eric-wood/presets-pedal-template/template.kicad_pcb

## KiCad design template.kicad_pcb (2021-06-12)

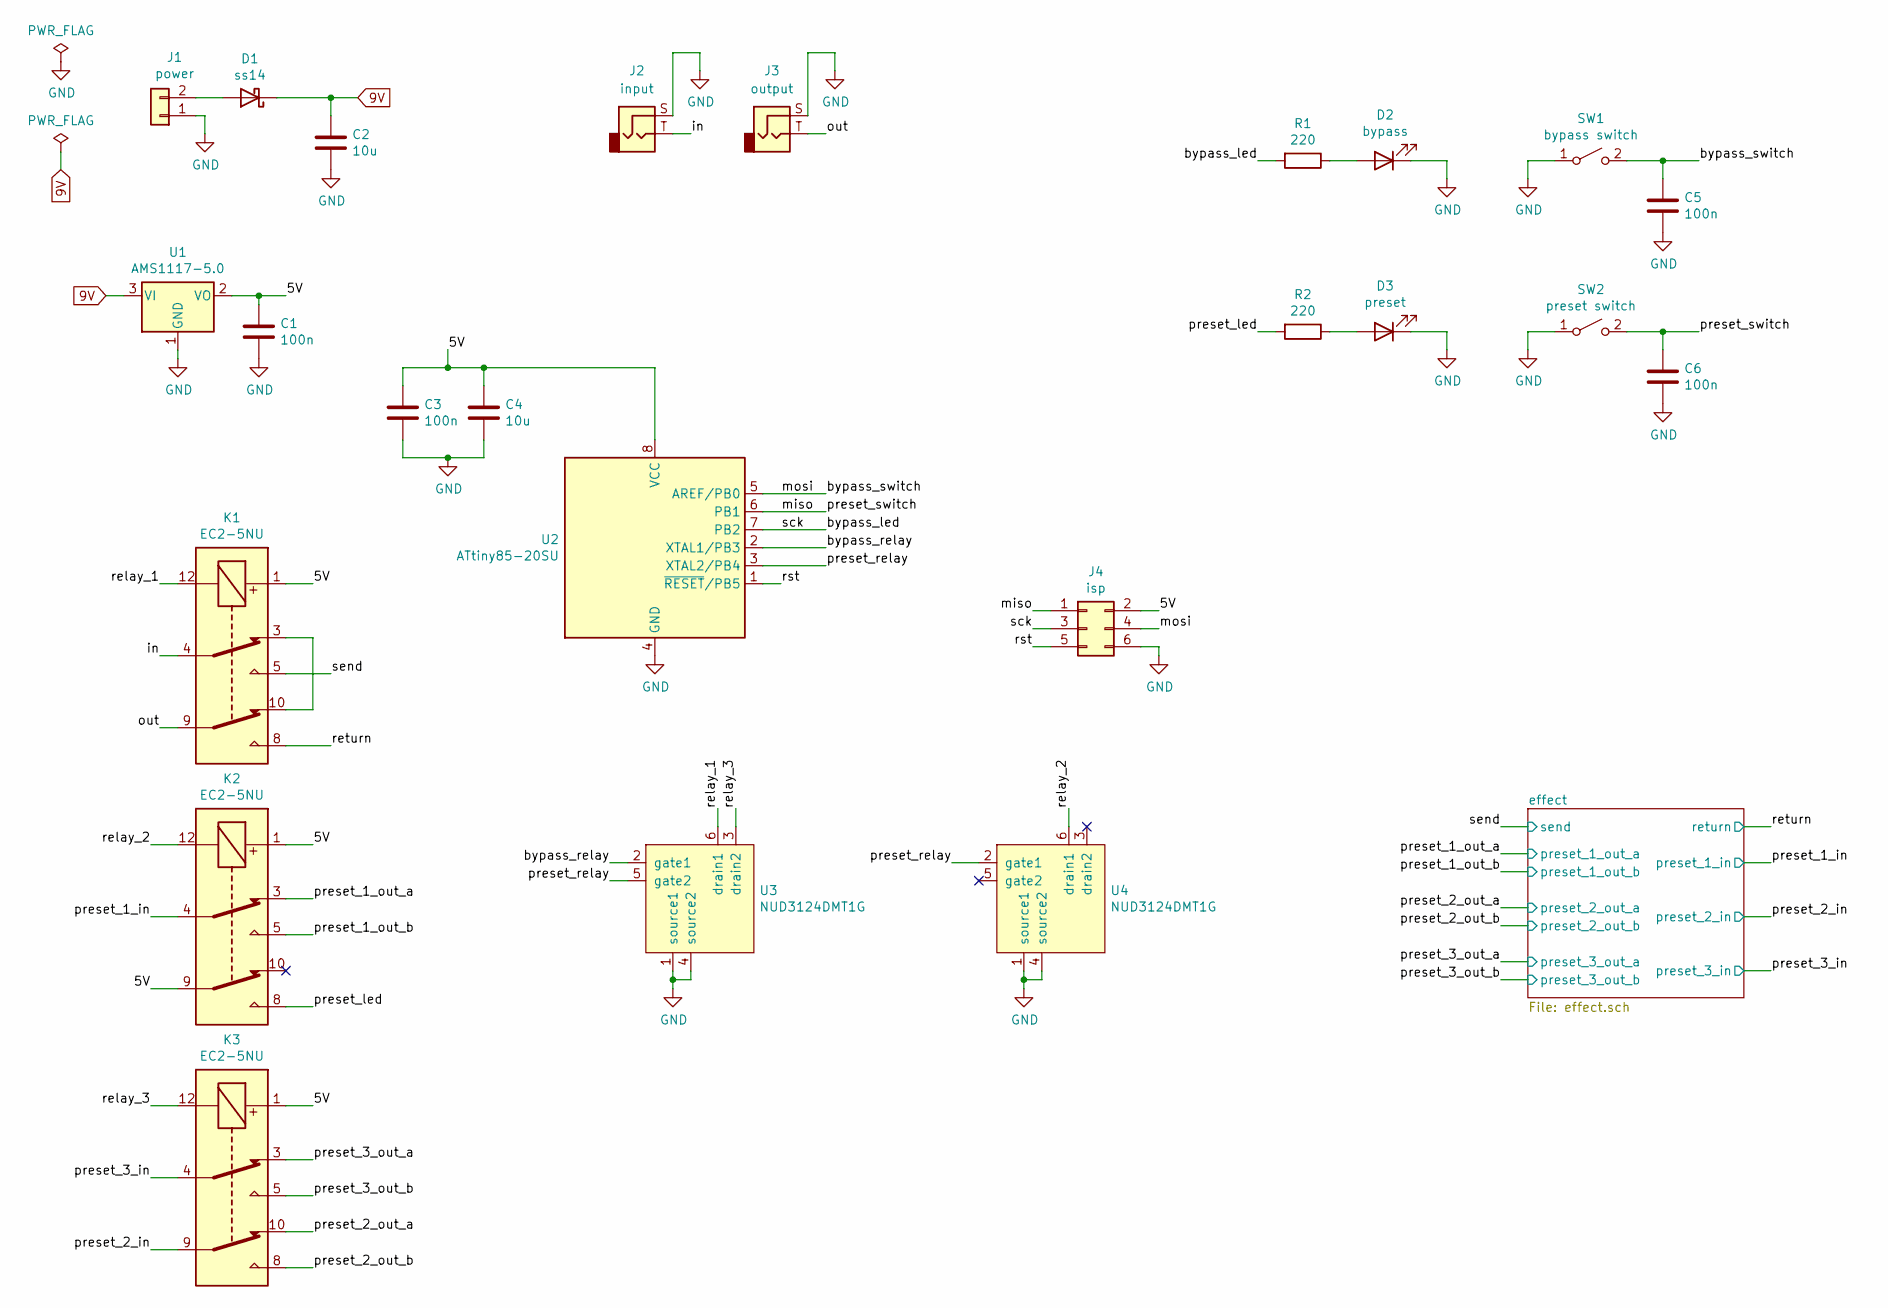
[picture p1: schematic template.sch]

Parts:
C1, C3, C5, C6: 100n; C_0603_1608Metric; LCSC C14663
C2, C4: 10u; C_1206_3216Metric; LCSC C13585
D1: ss14; D_SMA; LCSC C2480
D2: bypass; LED_D5.0mm_compact
D3: preset; LED_D5.0mm_compact
J1: power; PinHeader_1x02_P2.54mm_Vertical
J2: input; Jack_6.35mm_Neutrik_NMJ4HCD2_Horizontal
J3: output; Jack_6.35mm_Neutrik_NMJ4HCD2_Horizontal
J4: isp; PinHeader_2x03_P2.54mm_Vertical
K1, K2, K3: EC2-5NU; Relay_DPDT_Kemet_EC2
R1, R2: 220; R_0603_1608Metric; LCSC C22962
SW1: bypass switch; JST_XH_B2B-XH-A_1x02_P2.50mm_Vertical
SW2: preset switch; JST_XH_B2B-XH-A_1x02_P2.50mm_Vertical
U1: AMS1117-5.0; SOT-223-3_TabPin2; LCSC C6187
U2: ATtiny85-20SU; SOIJ-8_5.3x5.3mm_P1.27mm
U3, U4: NUD3124DMT1G; SC-74-6_1.5x2.9mm_P0.95mm

Connections:
9V: C2.1, D1.1 (K), U1.3 (VI); also elsewhere on the board
/5V: C1.1, C3.1, C4.1, J4.2, K1.1, K2.1, K2.9, K3.1, U1.2 (VO), U2.8 (VCC)
/bypass_led: J4.3, R1.2, U2.7 (PB2)
/bypass_relay: U2.2 (XTAL1/PB3), U3.2 (gate1)
/bypass_switch: C5.1, J4.4, SW1.2 (B), U2.5 (AREF/PB0)
/in: J2.T, K1.4
/miso: C6.1, J4.1, SW2.2 (B), U2.6 (PB1)
/out: J3.T, K1.9
/preset_1_in: K2.4; also elsewhere on the board
/preset_1_out_a: K2.3; also elsewhere on the board
/preset_1_out_b: K2.5; also elsewhere on the board
/preset_2_in: K3.9; also elsewhere on the board
/preset_2_out_a: K3.10; also elsewhere on the board
/preset_2_out_b: K3.8; also elsewhere on the board
/preset_3_in: K3.4; also elsewhere on the board
/preset_3_out_a: K3.3; also elsewhere on the board
/preset_3_out_b: K3.5; also elsewhere on the board
/preset_led: K2.8, R2.2
/preset_relay: U2.3 (XTAL2/PB4), U3.5 (gate2), U4.2 (gate1)
/relay_1: K1.12, U3.6 (drain1)
/relay_2: K2.12, U4.6 (drain1)
/relay_3: K3.12, U3.3 (drain2)
/return: K1.8; also elsewhere on the board
/rst: J4.5, U2.1 (~RESET~/PB5)
/send: K1.5; also elsewhere on the board
GND: C1.2, C2.2, C3.2, C4.2, C5.2, C6.2, D2.1 (K), D3.1 (K), J1.1, J2.S, J3.S, J4.6, SW1.1 (A), SW2.1 (A), U1.1 (GND), U2.4 (GND), U3.1 (source1), U3.4 (source2), U4.1 (source1), U4.4 (source2); also elsewhere on the board
unnamed: D1.2 (A), J1.2
unnamed: D2.2 (A), R1.1
unnamed: D3.2 (A), R2.1
unnamed: K1.3, K1.10

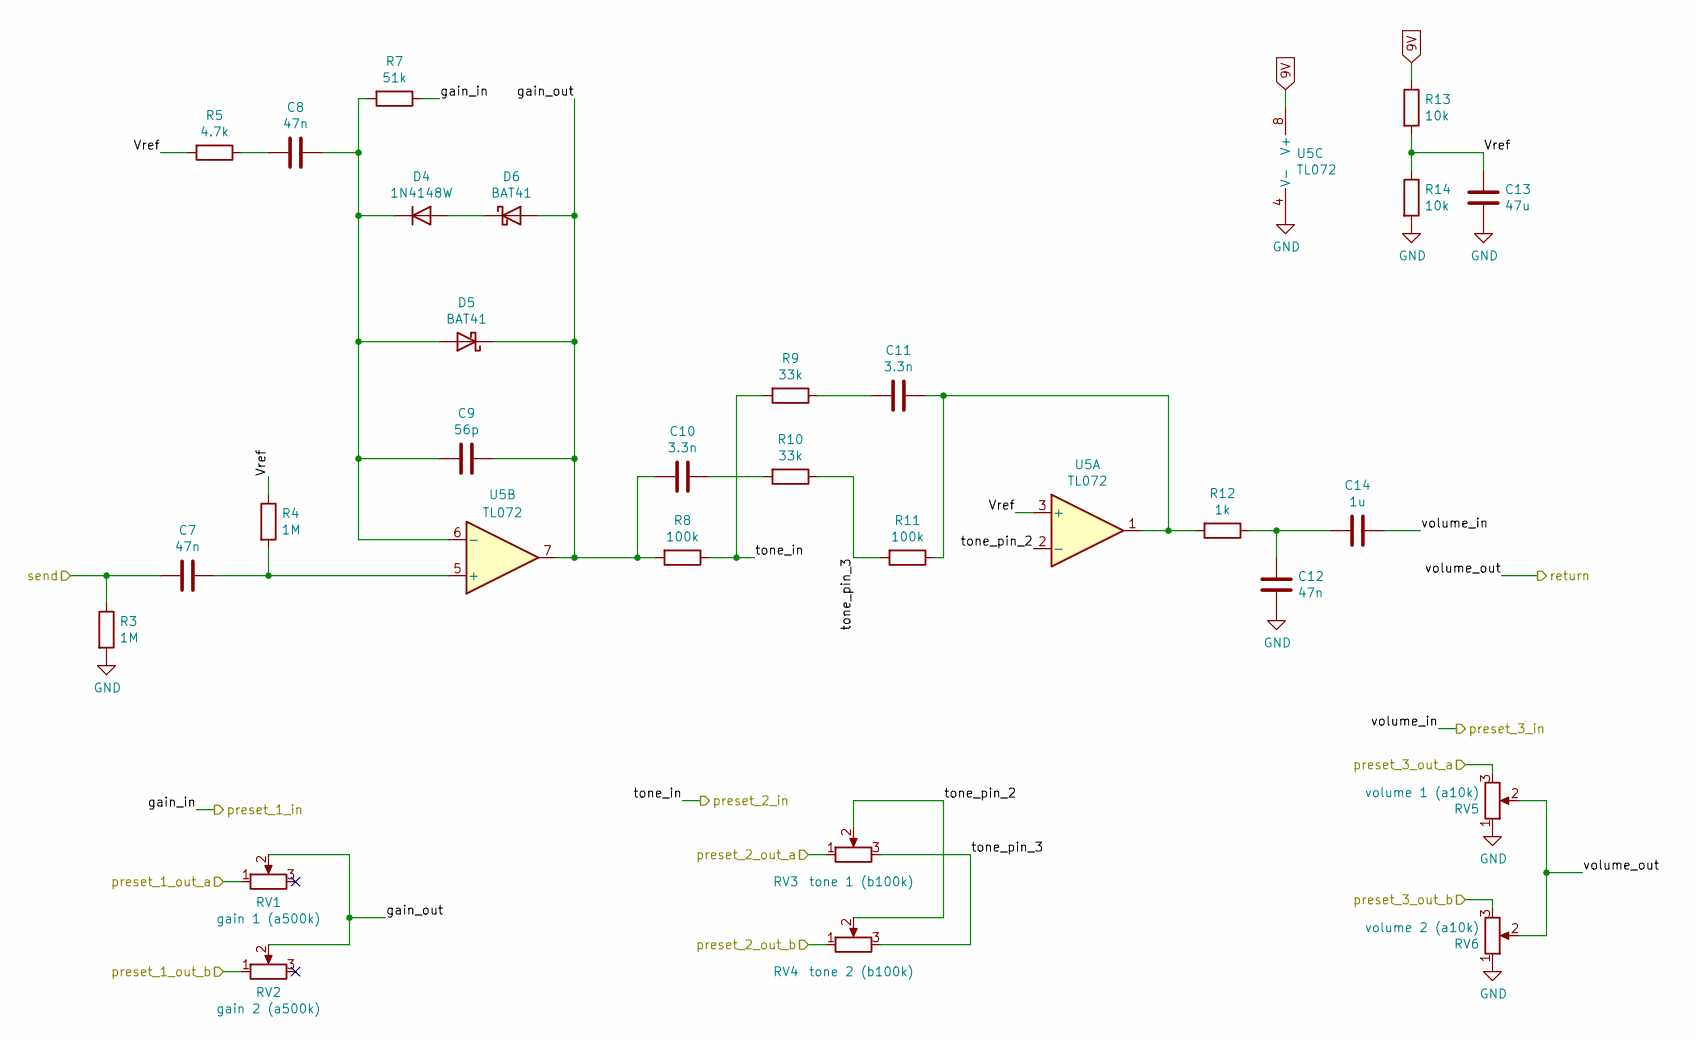
[picture p2: schematic effect.sch]

Parts:
C7, C8, C12: 47n; C_0603_1608Metric; LCSC C1622
C9: 56p; C_0603_1608Metric; LCSC C39148
C10, C11: 3.3n; C_0603_1608Metric; LCSC C1613
C13: 47u; C_1206_3216Metric; LCSC C96123
C14: 1u; C_0603_1608Metric; LCSC C15849
D4: 1N4148W; D_SOD-123; LCSC C81598
D5, D6: BAT41; D_DO-35_SOD27_P7.62mm_Horizontal
R3, R4: 1M; R_0603_1608Metric; LCSC C22935
R5: 4.7k; R_0603_1608Metric; LCSC C23162
R7: 51k; R_0603_1608Metric; LCSC C23196
R8, R11: 100k; R_0603_1608Metric; LCSC C25803
R9, R10: 33k; R_0603_1608Metric; LCSC C4216
R12: 1k; R_0603_1608Metric; LCSC C21190
R13, R14: 10k; R_0603_1608Metric; LCSC C25804
RV1: gain 1 (a500k); alpha_pot_16mm
RV2: gain 2 (a500k); alpha_pot_16mm
RV3: tone 1 (b100k); alpha_pot_16mm
RV4: tone 2 (b100k); alpha_pot_16mm
RV5: volume 1 (a10k); alpha_pot_16mm
RV6: volume 2 (a10k); alpha_pot_16mm
U5: TL072; SOIC-8_3.9x4.9mm_P1.27mm; LCSC C6961

Connections:
9V: R13.1, U5.8 (V+); also elsewhere on the board
/effect/Vref: C13.1, R4.1, R5.2, R13.2, R14.1, U5.3 (+)
/effect/gain_out: C9.1, C10.2, D5.1 (K), D6.2 (A), R8.2, RV1.2, RV2.2, U5.7
/effect/tone_pin_2: RV3.2, RV4.2, U5.2 (-)
/effect/tone_pin_3: R10.1, R11.2, RV3.3, RV4.3
/preset_1_in: R7.1; also elsewhere on the board
/preset_1_out_a: RV1.1; also elsewhere on the board
/preset_1_out_b: RV2.1; also elsewhere on the board
/preset_2_in: R8.1, R9.2; also elsewhere on the board
/preset_2_out_a: RV3.1; also elsewhere on the board
/preset_2_out_b: RV4.1; also elsewhere on the board
/preset_3_in: C14.1; also elsewhere on the board
/preset_3_out_a: RV5.3; also elsewhere on the board
/preset_3_out_b: RV6.3; also elsewhere on the board
/return: RV5.2, RV6.2; also elsewhere on the board
/send: C7.2, R3.1; also elsewhere on the board
GND: C12.1, C13.2, R3.2, R14.2, RV5.1, RV6.1, U5.4 (V-); also elsewhere on the board
unnamed: C7.1, R4.2, U5.5 (+)
unnamed: C8.1, C9.2, D4.1 (K), D5.2 (A), R7.2, U5.6 (-)
unnamed: C8.2, R5.1
unnamed: C10.1, R10.2
unnamed: C11.1, R11.1, R12.2, U5.1
unnamed: C11.2, R9.1
unnamed: C12.2, C14.2, R12.1
unnamed: D4.2 (A), D6.1 (K)

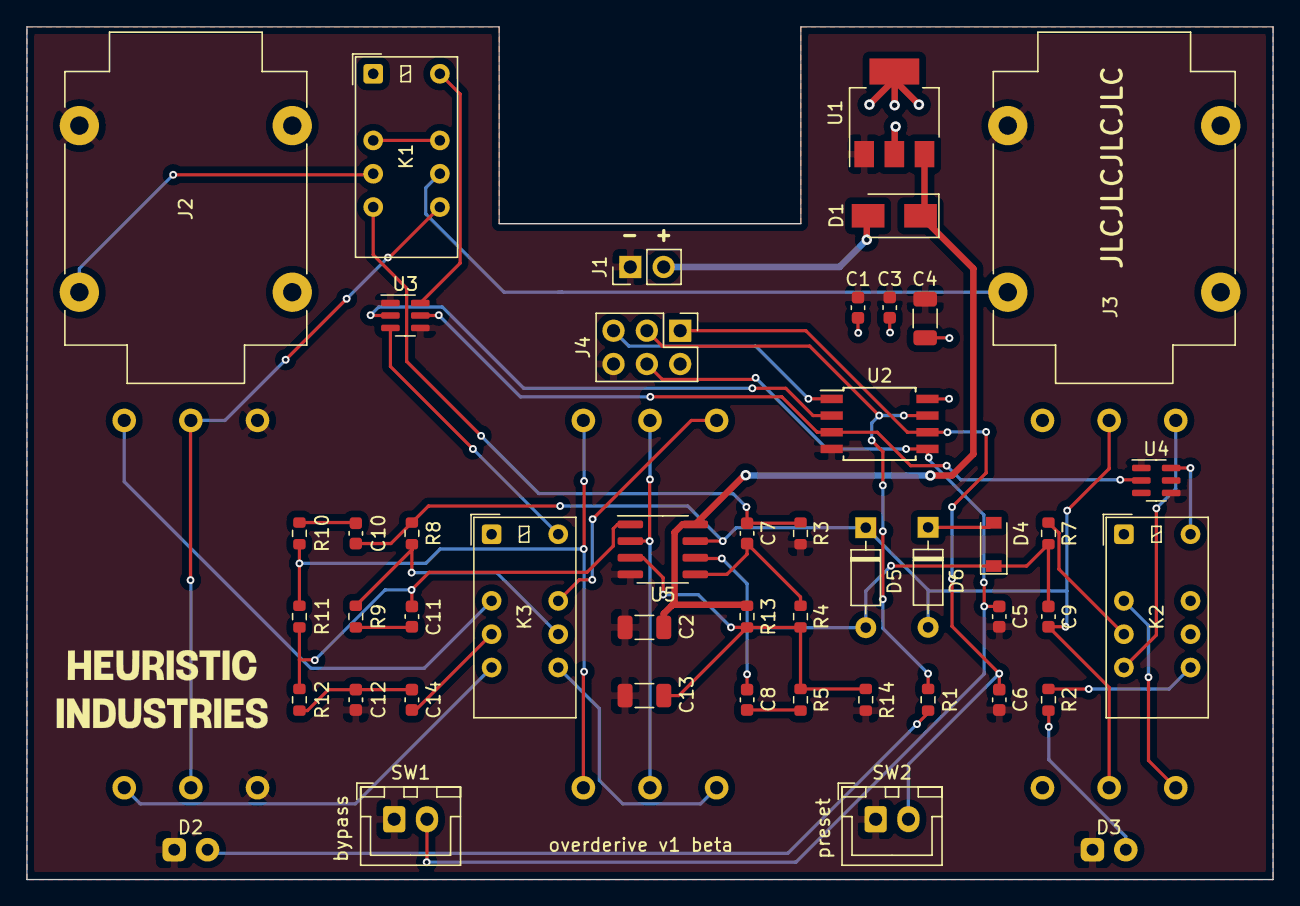
[picture p3: board template.kicad_pcb from above]

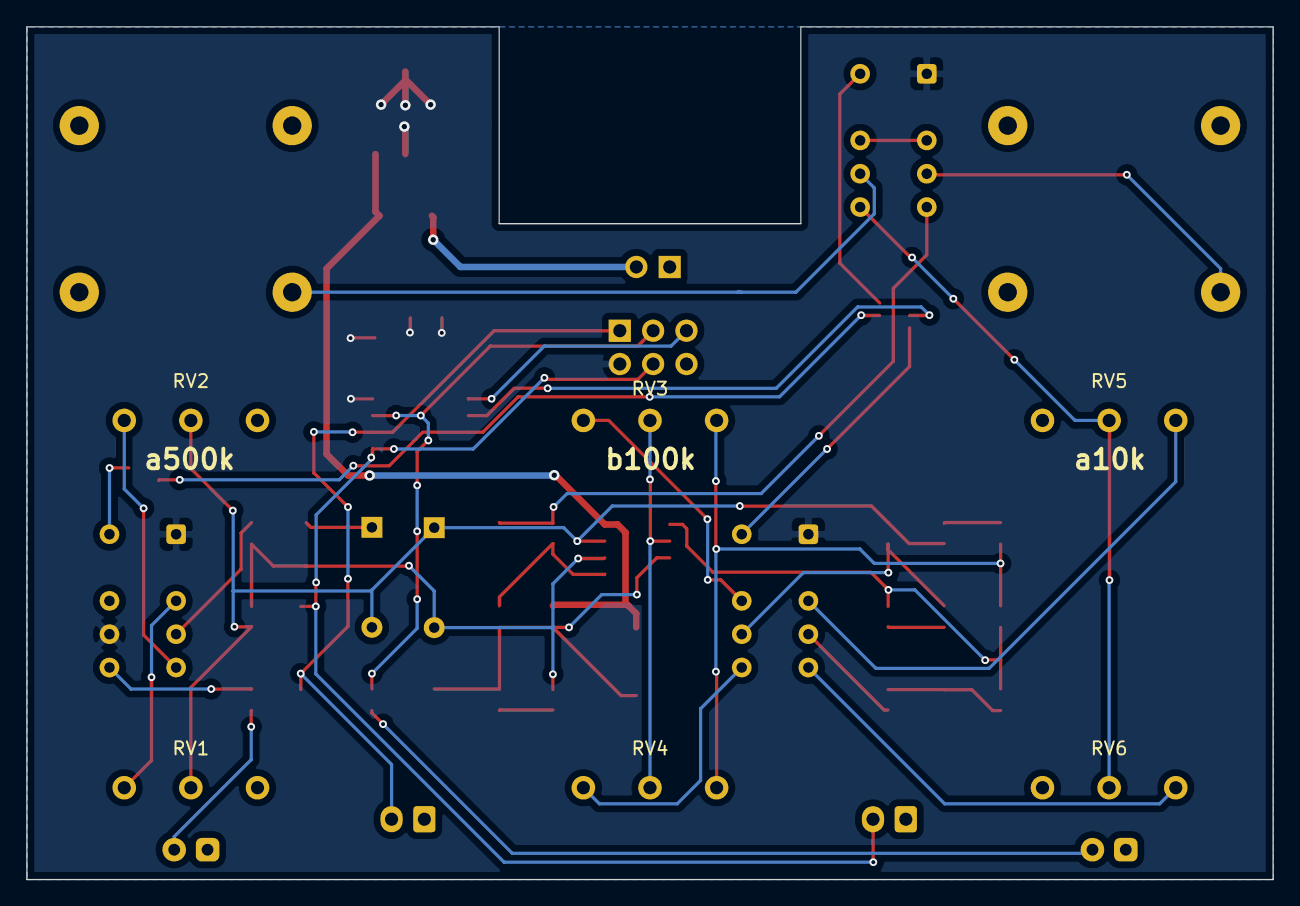
[picture p4: board template.kicad_pcb from below]

Board: 2 copper layers, 95.0 x 65.0 mm, 54 parts (6 on the bottom side), 42 nets.

Other parts of the board:
Ref**: Val**; logo
