eric-wood/presets-pedal-template/(commit log)

2021-05-03 LED control, programming header, switches
    [template.kicad_pcb, template.sch]
2021-05-04 Switch debouncing
    [template.sch]
2021-05-29 Read for review
    [effect.sch, template.sch]
2021-05-29 Fix a few values
    [effect.sch, template.sch]
2021-05-29 Now with an input buffer to preserve phase
    [effect.sch, template.sch]
2021-05-30 Add resistor footprints/part numbers
    [effect.sch, template.sch]
2021-05-30 Everything except those damn pots
    [effect.sch, template.sch]
2021-05-30 Added pot footprints
    [effect.sch]
2021-05-30 Pot and jack positions
    [template.kicad_pcb]
2021-05-31 Lots of progress
    [template.kicad_pcb, template.sch]
2021-05-31 Some layout improvements
    [template.kicad_pcb, template.sch]
2021-05-31 Is this better? Tough to say
    [template.kicad_pcb]
2021-05-31 Need to start over
    [template.kicad_pcb]
2021-05-31 This is better
    [template.kicad_pcb]
2021-06-08 Use better schematic
    [effect.sch, template.kicad_pcb]
2021-06-08 The orientation of these is gonna be the death of me
    [effect.sch]
2021-06-08 I think I have the positioning worked out
    [template.kicad_pcb]
2021-06-09 I think placement is done?
    [template.kicad_pcb]
2021-06-10 so close
    [template.kicad_pcb]
2021-06-11 oh yeeaaa
    [template.kicad_pcb]
2021-06-12 Sent it off 2 tha fab
    [template-B_Cu.gbr, template-B_Mask.gbr, template-B_Paste.gbr, template-B_SilkS.gbr, template-Dwgs_User.gbr, template-Edge_Cuts.gbr, template-F_Cu.gbr, template-F_Mask.gbr]
2021-07-20 Use solid state switching and charge pump
    [effect.sch, template.sch]
2021-08-02 Use 4053 switch, correct poor decisions made earlier
    [effect.sch, template.sch]
2021-08-03 Fix a few issues
    [effect.sch, template.sch]
